interactionresearchstudio/VisionCam_Battery_Holder/Pi Cam Back.stl

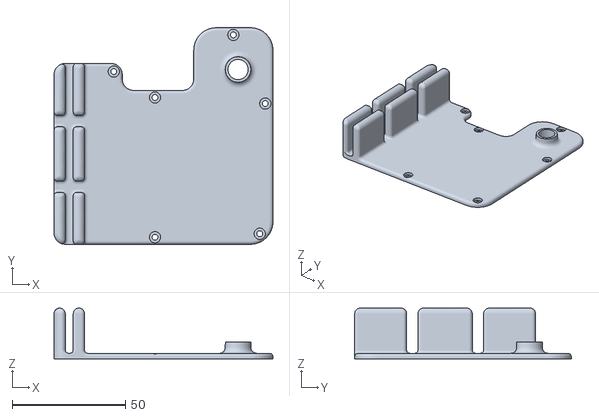
[picture p3: CAD file, 2017-12-20]
Pi Cam Back.stl
96.9 x 95.9 x 22.5
